JacobDirks/Dirks_EGR314_S26/docs/index.md

---
title: Welcome
tags:
- tag1
- tag2
---
<center>
<font size= "6">Jacob Dirks Datasheet</font><br>
as part of<br>
<font size= "8"> Rugged Surveyor</font><br>
for<br>
<font size= "5"> Team 308 </font><br>

**Submission: May 04, 2026**
</center>

## **Introduction**

* This datasheet is to help define the drive system for the Rugged Surveyor. This system is crucial to the submarine to be able to go underwater and gather data regarding environmental changes specifically through a photo-resistor for light sensing and a temperature sensor. The goal of the drive train is to allow the robot to travel: forward, reverse, and their diagonals as well as turn left or right. This will be accomplished through 3 DC motors and 2 RC servo motors. As for the goal of the overall project, we want to protect human lives and make the process of exploring new environments less dangerous.

### **Project Summary**

* This project is to create full robotic system that can work either as an attachment to a larger robot or as a standalone robot. In this case my team is working to build a submarine that will be able to gather temperature data and light levels in a given area. In order to access the full team's report please access this link: [linked team report.](https://egr314-s-2026-308.github.io/)

### **My Contribution**

* My subsystem is in charge of the drive system for the submarine and using SPI protocol for communication to parts as I use UART for inter controller communication.
* ["Block Diagram"](https://jacobdirks.github.io/Dirks_EGR314_S26/02-Block-Diagram/Block-Diagram/)
* ["Component Selection"](https://jacobdirks.github.io/Dirks_EGR314_S26/03-Component-Selection/Component-Selection/)
* ["Power Budget"](https://jacobdirks.github.io/Dirks_EGR314_S26/10-Power-Budget/Power-Budget/)
* ["Schematic"](https://jacobdirks.github.io/Dirks_EGR314_S26/05-Schematic/schematic/)
* ["PCB"](https://jacobdirks.github.io/Dirks_EGR314_S26/06-PCB/pcb/)
* ["BOM"](https://jacobdirks.github.io/Dirks_EGR314_S26/04-BOM/BOM/)
* ["API"](https://jacobdirks.github.io/Dirks_EGR314_S26/07-API/api/)
* ["Reflection"](https://jacobdirks.github.io/Dirks_EGR314_S26/08-Reflection/Reflection/)
* ["Hardware Version 2"](https://jacobdirks.github.io/Dirks_EGR314_S26/Hardware%20V2.0/HardwareV2/)
* ["Appendix"](https://jacobdirks.github.io/Dirks_EGR314_S26/Appendix/)
  * ["Microcontroller Selection Process"](https://jacobdirks.github.io/Dirks_EGR314_S26/Appendix/02-Microcontroller-Selection/esp-32-table/)
