JacobDirks/Dirks_EGR314_S26/docs/05-Schematic/schematic.md

---
title: Module Schematic
---

## **Overview**

This schematic is design to support the shared power system required by the team and act as the drive system.

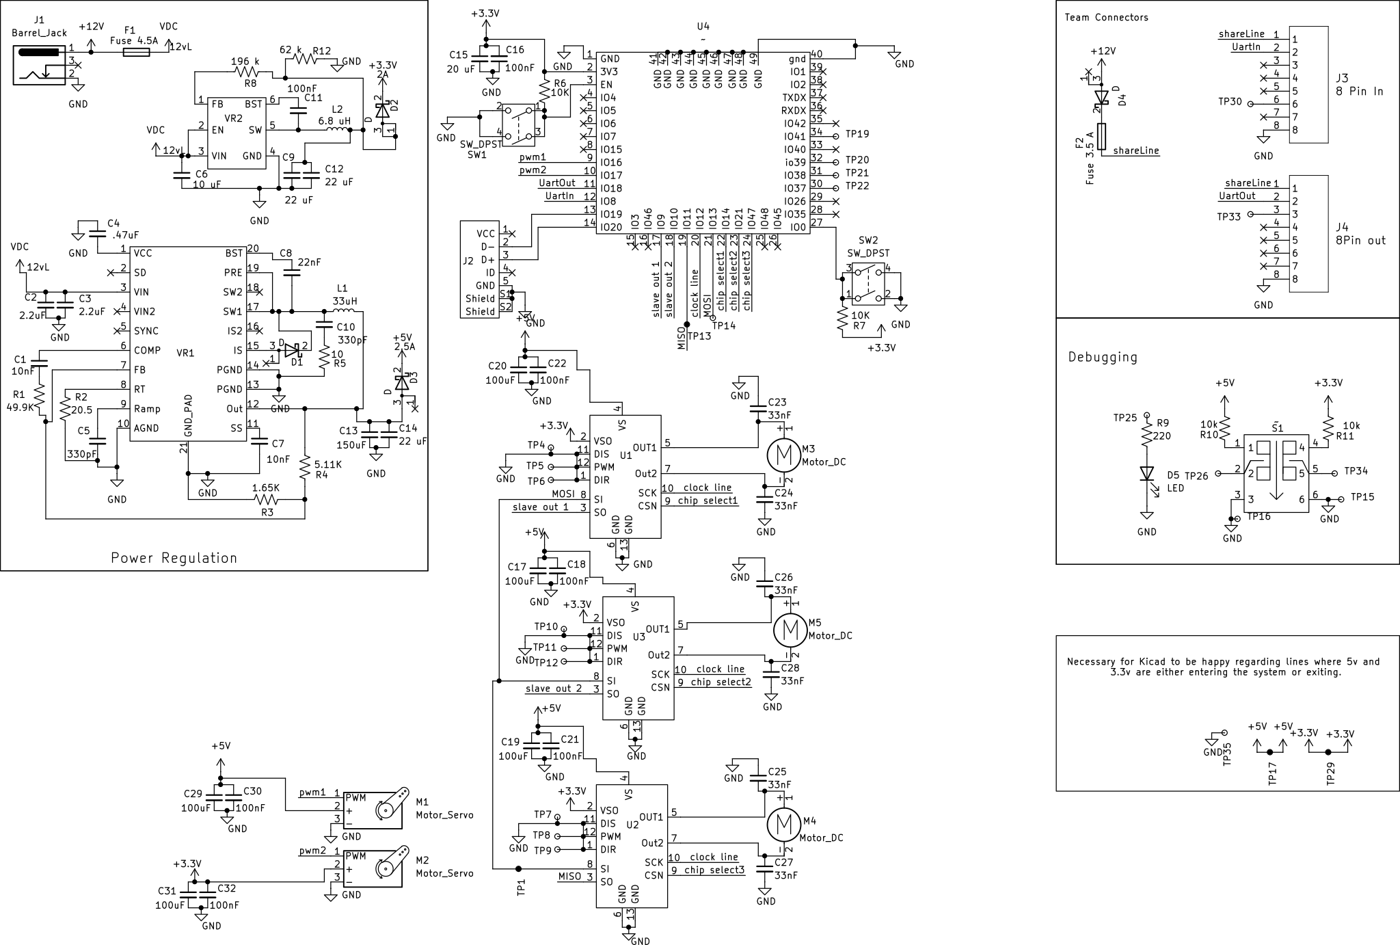
[picture p1: docs/05-Schematic/JdirksSchematic.png]
schematic

**Figure #1:** Showing the schematic.

## **Resources**

The schematic is available [*as a pdf here*](JdirksSchematic.pdf), and the Zip folder of the [*project here*](Projects.zip).
