JacobDirks/Dirks_EGR314_S26/docs/06-PCB/pcb.md

---
title: Module's PCB
---

## **PCB**

This pcb is designed to not only match the schematic but also support the team's movement requirements.

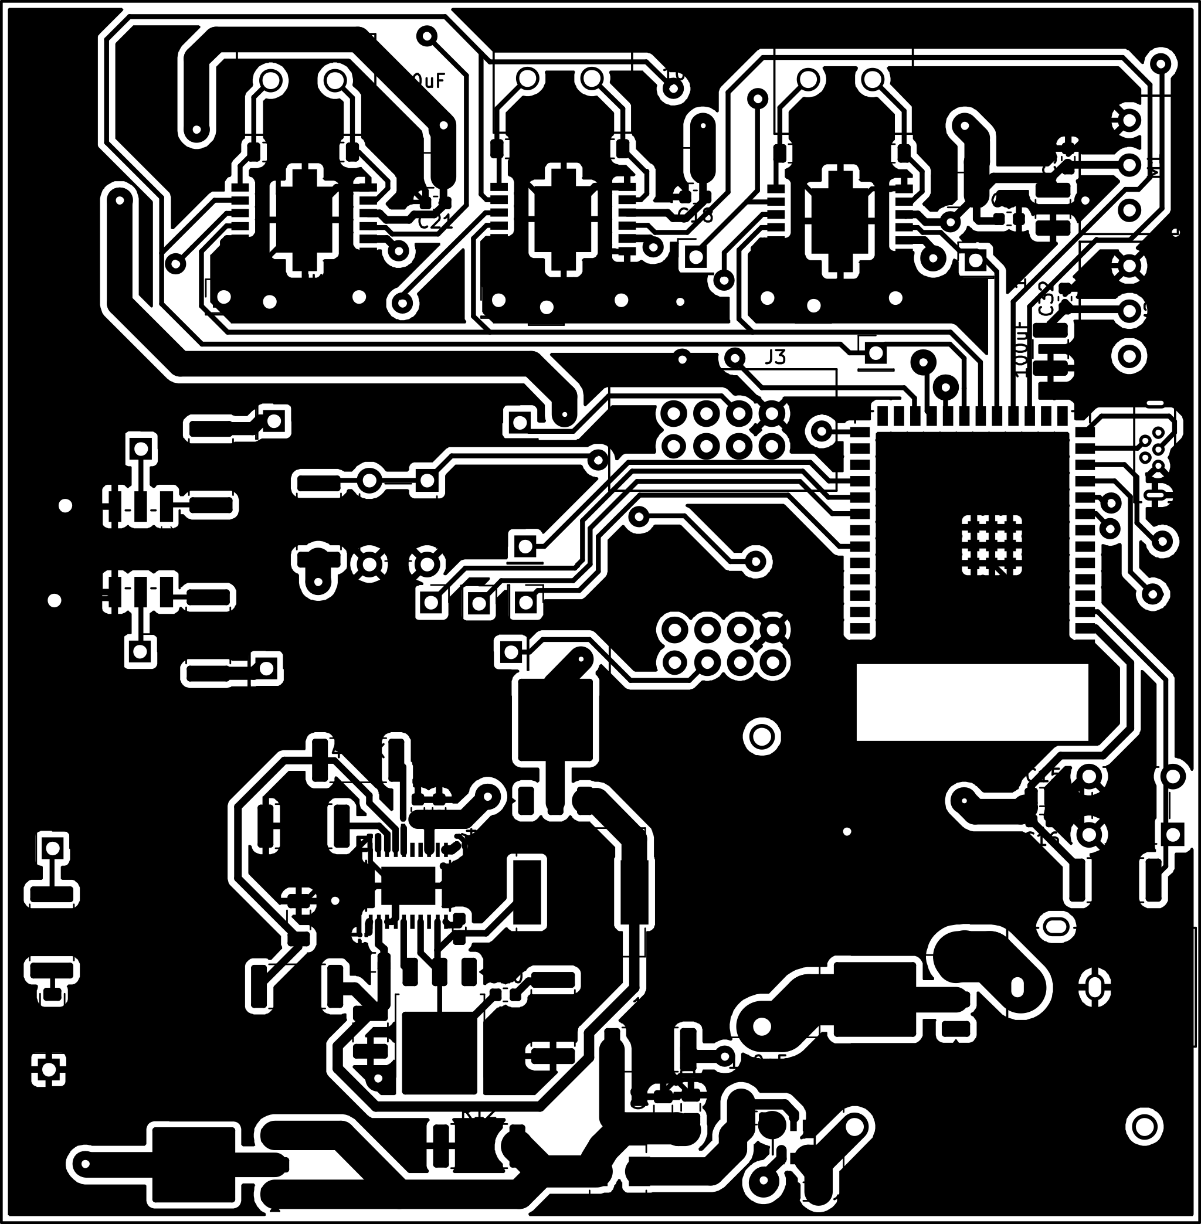
[picture p2: docs/06-PCB/DirksPCB.png]
schematic

**Figure #1:** Showing a screenshot as rendered through KiCad of my pcb.

## **Resources**

The schematic is available [*as a pdf here*](DirksPCB.pdf), and the Zip folder of the [*project here*](Projects.zip) and the [*Gerber files*](Dirks_Gerbers.zip).

## **FinalImages**

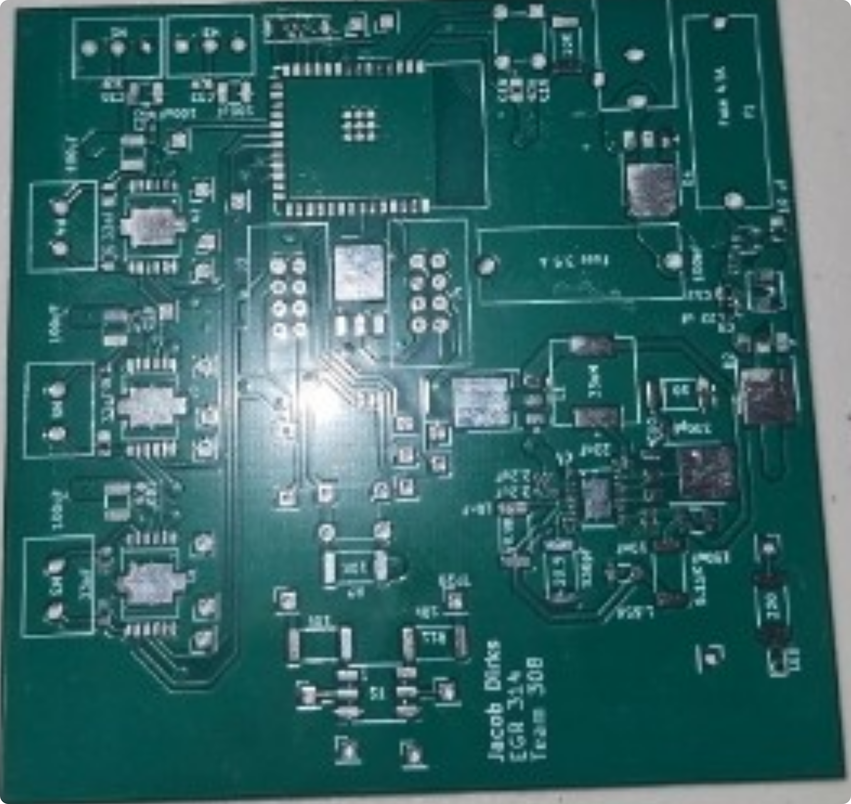
[picture p3: docs/06-PCB/FrontHalf.png]
Empty Front Image

**Figure #2:** Empty top image of the PCB

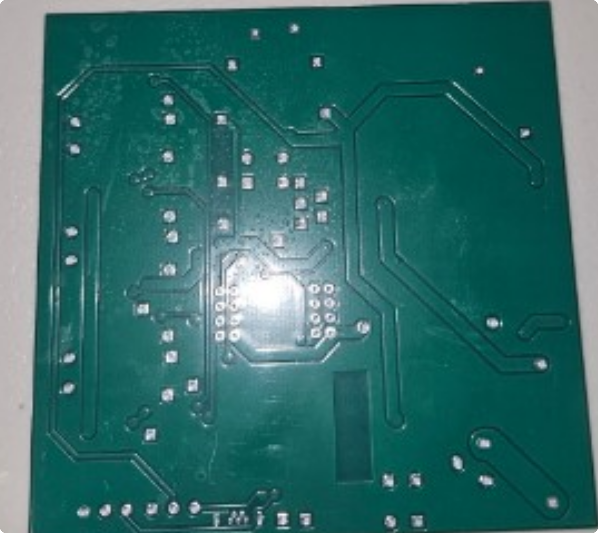
[picture p4: docs/06-PCB/backHalf.png]
Empty Back Image

**Figure #3:** Empty bottom image of the PCB

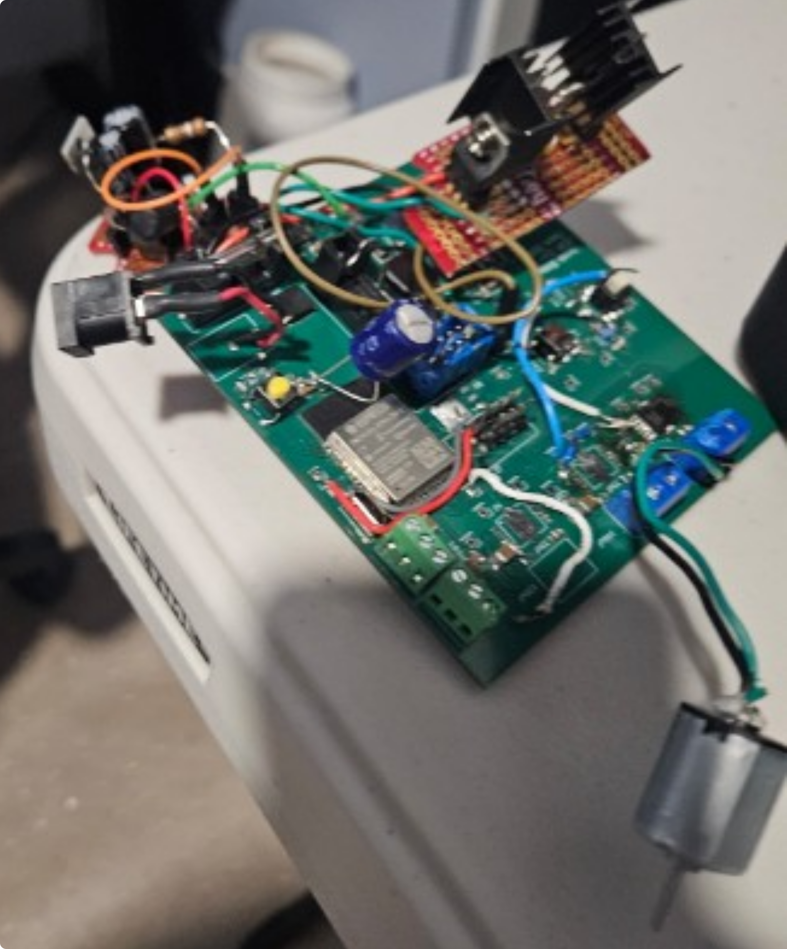
[picture p5: docs/06-PCB/finalTopPCB.png]
Final Front Populated

**Figure #4:** Populated top image of the PCB

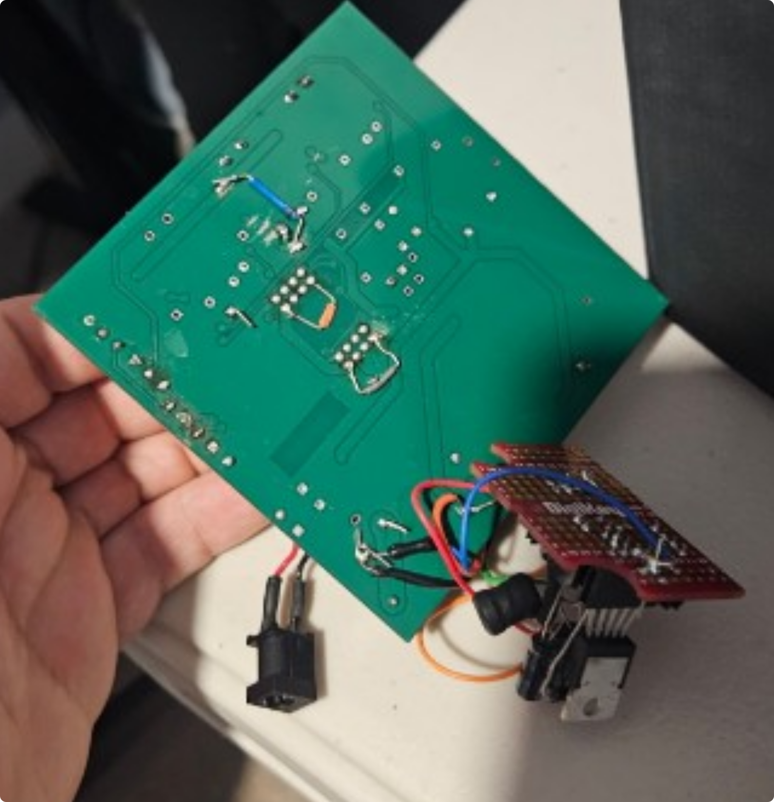
[picture p6: docs/06-PCB/finalBottomPCB.png]
Final Back Populated

**Figure #5:** Populated bottom image of the PCB
