JacobDirks/Dirks_EGR314_S26/docs/Resources/Resources.md

---
title = Resources
---

## **Code Resources**

As provided earlier in the website here is the ["code base."](Dirks_subsystem.zip)

## **3D Print Resources**

This section is new but holds the zip of the ["3D print files"](3dPartsSubmarine.zip) utilized by my subsystem and the team's overall model.
