JacobDirks/Dirks_EGR314_S26/docs/04-BOM/DirksBOM.pdf

Part Name/Description

Unit
Quantity

Unit
Prototype
Cost

Total
Prototype
Cost

Unit
Production
Cost

Total
Production
Cost | Manufacturer | Manufacturer Part # | Vendor Link
ESP 32 - Wroom N8 | 1 | $5.49 | $5.49 | $5.49 | $5.49 | Espressif | ESP32-S3-WROOM-1-N8https://www.digikey.com/en/products/detail/espressif-systems/ESP32-S3-WROOM-1-N8/15200089
CAP CER 330PF 16V X7R 0201 | 2 | $0.10 | $0.20 | $0.10 | $0.20 | Murata | GRM033R71C331KA01Dhttps://www.digikey.com/en/products/detail/murata-electronics/GRM033R71C331KA01D/2543513
CAP CER 10000PF 10V X7S 010052 | $0.08 | $0.16 | $0.08 | $0.16 | Murata | GRM022C71A103KE01Lhttps://www.digikey.com/en/products/detail/murata-electronics/GRM022C71A103KE01L/16820994
CAP CER 0.022UF 6.3V X5R 0201 1 | $0.10 | $0.10 | $0.10 | $0.10 | Murata | GRM033R60J223KE01Dhttps://www.digikey.com/en/products/detail/murata-electronics/GRM033R60J223KE01D/702435
CAP 0805 250V 33 NF X7R | 6 | $0.18 | $1.08 | $0.18 | $1.08 | Yageo | CC0805KKX7RYBB333 | https://www.digikey.com/en/products/detail/yageo/CC0805KKX7RYBB333/20376243
CAP CER 0.1UF 10V X5R 0201 | 7 | $0.08 | $0.56 | $0.08 | $0.56 | Murata | GRM033R61A104KE15Dhttps://www.digikey.com/en/products/detail/murata-electronics/GRM033R61A104KE15D/2269163
CAP CER 0.47UF 6.3V X5R 0201 1 | $0.08 | $0.08 | $0.08 | $0.08 | Murata | GRM033R60J474KE90Dhttps://www.digikey.com/en/products/detail/murata-electronics/GRM033R60J474KE90D/5027494
CAP CER 2.2UF 16V X5R 0603 | 2 | $0.10 | $0.20 | $0.10 | $0.20 | Samsung Electro-Mechanics CL10A225KO8NNNC | https://www.digikey.com/en/products/detail/samsung-electro-mechanics/CL10A225KO8NNNC/3886698
CAP CER 10UF 16V X5R 0805 | 1 | $0.08 | $0.08 | $0.08 | $0.08 | Taiyo Yuden | EMK212BJ106KG-T | https://www.digikey.com/en/products/detail/taiyo-yuden/EMK212BJ106KG-T/930647
CAP CER 22UF 6.3V 20% X5R 04024 | $0.28 | $1.12 | $0.28 | $1.12 | Murata | GRM155R60J226ME11Dhttps://www.digikey.com/en/products/detail/murata-electronics/GRM155R60J226ME11D/5253988
CAP CER 100UF 16V X5R 1210 | 5 | $1.74 | $8.70 | $1.74 | $8.70 | Taiyo Yuden | EMK325ABJ107MM-T | https://www.digikey.com/en/products/detail/taiyo-yuden/EMK325ABJ107MM-T/2774763
CAP CER 150UF 6.3V X5R 1210 1 | $1.31 | $1.31 | $1.31 | $1.31 | Samsung Electro-Mechanics CL32A157MQVNNNE | https://www.digikey.com/en/products/detail/samsung-electro-mechanics/CL32A157MQVNNNE/3889025
RES 10 OHM 5% 2W 2512 | 1 | $0.44 | $0.44 | $0.44 | $0.44 | Bourns | CRM2512-JW-100ELF | https://www.digikey.com/en/products/detail/bourns-inc/CRM2512-JW-100ELF/2563944
RES 20 OHM 5% 2W 2512 | 1 | $0.24 | $0.24 | $0.24 | $0.24 | Yageo | AC2512JK-7W20RL | https://www.digikey.com/en/products/detail/yageo/AC2512JK-7W20RL/17011699
RES 220 OHM 5% 2W 2512 | 1 | $0.53 | $0.53 | $0.53 | $0.53 | TE Connectivity Passive CRGH2512J220R | https://www.digikey.com/en/products/detail/te-connectivity-passive-product/CRGH2512J220R/2386098
RES 1.65K OHM 1% 2W 1206 | 1 | $1.39 | $1.39 | $1.39 | $1.39 | TE Connectivity Passive 3503G2B1K65FTD | https://www.digikey.com/en/products/detail/te-connectivity-passive-product/3503G2B1K65FTD/16808524
RES 5.11K OHM 1% 2W 2512 | 1 | $0.52 | $0.52 | $0.52 | $0.52 | Bourns | CRM2512-FX-5111ELF | https://www.digikey.com/en/products/detail/bourns-inc/CRM2512-FX-5111ELF/7314836
RES 10K OHM 1% 2W 2512 | 1 | $0.51 | $0.51 | $0.51 | $0.51 | TE Connectivity Passive CRGP2512F10K | https://www.digikey.com/en/products/detail/te-connectivity-passive-product/CRGP2512F10K/8577335
RES 49.9K OHM 1% 2W 2512 | 1 | $0.52 | $0.52 | $0.52 | $0.52 | Bourns | CRM2512-FX-4992ELF | https://www.digikey.com/en/products/detail/bourns-inc/CRM2512-FX-4992ELF/4698402
RES 62K OHM 5% 1/8W 0805 | 1 | $10.00 | $10.00 | $10.00 | $10.00 | Yageo | RC0805JR-0762KL | https://www.digikey.com/en/products/detail/yageo/RC0805JR-0762KL/728360
RES SMD 196K OHM 1% 1/4W 08051 | $0.10 | $0.10 | $0.10 | $0.10 | Vishay Dale | RES SMD 196K OHM 1% 1/4W 0805 https://www.digikey.com/en/products/detail/vishay-dale/CRCW0805196KFKEA/1175896
DIODE SCHOTTKY 100V 3.5A TO252AA 3 | $0.40 | $1.20 | $0.40 | $1.20 | Vishay | VS-30WQ10FNTR-M3 | https://www.digikey.com/en/products/detail/vishay-general-semiconductor-diodes-division/VS-30WQ10FNTR-M3/4933700
LED GREEN CLEAR SMD | 1 | $0.10 | $0.10 | $0.10 | $0.10 | Lite-On | LTST-C170GKT | https://www.digikey.com/en/products/detail/liteon/LTST-C170GKT/269226
FUSE GLASS 5A 250VAC 5X20MM1 | $0.63 | $0.63 | $0.63 | $0.63 | Schurter | 34.3124 | https://www.digikey.com/en/products/detail/schurter-inc/0034-3124/639681
FUSE GLASS 4A 250VAC 5X20MM1 | $0.63 | $0.63 | $0.63 | $0.63 | Schurter | 34.3123 | https://www.digikey.com/en/products/detail/schurter-inc/0034-3123/639683
FIXED IND 4.7UH 2.5A 147.2 MOHM1 | $0.19 | $0.19 | $0.19 | $0.19 | Taiyo Yuden | NRS4018T6R8MDGJ | https://www.digikey.com/en/products/detail/taiyo-yuden/NRS4018T6R8MDGJ/2648972
FIXED IND 33UH 2.5A 93.6 MOHM1 | $1.06 | $1.06 | $1.06 | $1.06 | Murata | 1274AS-H-330M=P3 | https://www.digikey.com/en/products/detail/murata-electronics/1274AS-H-330M-P3/5271492
Positional Rotation DC Motor Servomotor, RC (Hobby) 3 ~ 6VDC 2 | $5.95 | $11.90 | $5.95 | $11.90 | Adafruit | 4326 | https://www.digikey.com/en/products/detail/adafruit-industries-llc/4326/10419470
STANDARD MOTOR 11605 RPM 5V3 | $3.71 | $11.13 | $3.71 | $11.13 | NMB | PPN7PA12C1 | https://www.digikey.com/en/products/detail/nmb-technologies-corporation/PPN7PA12C1/2417079
8 Pin Connector | 2 | $1.48 | $2.96 | $1.48 | $2.96 | Molex | 702460801 | https://www.digikey.com/en/products/detail/molex/0702460801/760165
8 Pin Ribbon Cable | 2 | $5.00 | $10.00 | $5.00 | $10.00 | Amphenol | 10124667-Z0025YYLF | https://www.digikey.com/en/products/detail/amphenol-cs-fci/10124667-Z0025YYLF/7590774
Power Barrel Connector Jack 2.00mm ID (0.079"), 5.50mm OD (0.217") Through Hole, Right Angle 1 | $0.71 | $0.71 | $0.71 | $0.71 | Same Sky | PJ-102AH | https://www.digikey.com/en/products/detail/same-sky-formerly-cui-devices/PJ-102AH/408448
USB - micro B USB 2.0 | 1 | $0.77 | $0.77 | $0.77 | $0.77 | GCT | USB3131-30-0230-A | https://www.digikey.com/en/products/detail/gct/USB3131-30-0230-A/9859642
Switch button | 2 | $0.10 | $0.20 | $0.10 | $0.20 | Same Sky | TS02-66-55-BK-100-LCR-Dhttps://www.digikey.com/en/products/detail/same-sky-formerly-cui-devices-/TS02-66-55-BK-100-LCR-D/15634297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
SWITCH PB DPDT 0.1A 30V | 1 | $0.46 | $0.46 | $0.46 | $0.46 | E-Switch | TL2233OA | https://www.digikey.com/en/products/detail/e-switch/TL2233OA/15220943
IC HALF BRIDGE DRIVER 6A 12DSO3 | $3.55 | $10.65 | $3.55 | $10.65 | Infineon | IFX9201SGAUMA1 | https://www.digikey.com/en/products/detail/infineon-technologies/IFX9201SGAUMA1/5415542

# Bill of Materials Motor Subsystem

Buck Switching Regulator IC Positive Adjustable 1.225V 1 Output 2.5A 20-PowerTSSOP (0.173", 4.40mm Width) 1 | $3.77 | $3.77 | $3.77 | $3.77 | Texas InstrumentsLM5005MHX/NOPB | https://www.digikey.com/en/products/detail/texas-instruments/LM5005MHX-NOPB/1871800
Buck Switching Regulator IC Positive Fixed 3.3V 1 Output 2A SOT-23-6 Thin, TSOT-23-6 1 | $0.71 | $0.71 | $0.71 | $0.71 | Diode IncorporatedAP63203WU-7 | https://www.digikey.com/en/products/detail/diodes-incorporated/AP63203WU-7/9858426
3 Pin Screw Terminal | 2 | $0.71 | $1.42 | $0.71 | $1.42 | Adam Tech | EBWA-03-A | https://www.digikey.com/en/products/detail/adam-tech/EBWA-03-A/9830974
2 Pin Screw Terminal | 3 | $0.32 | $0.96 | $0.32 | $0.96 | Same Sky | TB002-500-02BE | https://www.digikey.com/en/products/detail/same-sky-formerly-cui-devices/TB002-500-02BE/10064069
Total Prototype cost $87.09 | Total Production cost$87.09

Datasheet Link | Supplier | Supplier Part # | # Ordered | Date Ordered | # Received | Surplu s | Schematic Reference Designators
https://documentation.espressif.com/esp32-s3-wroom-1_wroom-1u_datasheet_en.pdf Digikey | | 5407-ESP32-S3-WROOM-1-N8CT-ND 3 | | 3/12/2026 | 3 | 2 | U4
https://search.murata.co.jp/Ceramy/image/img/A01X/G101/ENG/GRM033R71C331KA01-01A.pdf Digikey | | 490-11359-1-ND | 2 | 3/12/2026 | 2 | 0 | C5,C10
https://search.murata.co.jp/Ceramy/image/img/A01X/G101/ENG/GRM022C71A103KE01-01A.pdf Digikey | | 490-GRM022C71A103KE01LCT-ND 1 | | 3/12/2026 | 2 | 0 | C1,C7
https://search.murata.co.jp/Ceramy/image/img/A01X/G101/ENG/GRM033R60J223KE01-01.pdf Digikey | | 490-3169-1-ND | 1 | 3/12/2026 | 1 | 0 | C8
https://www.yageo.com/en/Chart/Download/pdf/CC0805KKX7RYBB333 Digikey | | 13-CC0805KKX7RYBB333CT-ND 1 | | 3/12/2026 | 6 | 0 | C23,C24,C25,C26,C27,C28
https://search.murata.co.jp/Ceramy/image/img/A01X/G101/ENG/GRM033R61A104KE15-01A.pdf Digikey | | 490-5881-1-ND | 10 | 3/12/2026 | 10 | 3 | C11,C16,C18,C21,C22,C30,C32
https://search.murata.co.jp/Ceramy/image/img/A01X/G101/ENG/GRM033R60J474KE90-01.pdf Digikey | | 490-10409-1-ND | 1 | 3/12/2026 | 1 | 0 | C4
https://mm.digikey.com/Volume0/opasdata/d220001/medias/docus/421/CL10A225KO8NNNC_Spec.pdf Digikey | | 1276-1040-1-ND | 3 | 3/12/2026 | 3 | 1 | C2,C3
https://mm.digikey.com/Volume0/opasdata/d220001/medias/docus/8412/587_mlcc01hqAUTOe.pdf Digikey | | 587-1295-1-ND | 1 | 3/12/2026 | 1 | 0 | C6
https://search.murata.co.jp/Ceramy/image/img/A01X/G101/ENG/GRM155R60J226ME11-01A.pdf Digikey | | 490-GRM155R60J226ME11DCT-ND 6 | | 3/12/2026 | 6 | 2 | C9,C12,C14,C15
https://mm.digikey.com/Volume0/opasdata/d220001/medias/docus/8412/587_mlcc01hqAUTOe.pdf Digikey | | 587-3152-1-ND | 7 | 3/12/2026 | 7 | 2 | C17,C19,C20,C29,C31
https://weblib.samsungsem.com/mlcc/mlcc-ec-data-sheet.do?partNumber=CL32A157MQVNNN Digikey | | 1276-3367-1-ND | 1 | 3/12/2026 | 1 | 0 | C13
https://www.bourns.com/docs/product-datasheets/crm.pdf Digikey | | CRM2512-JW-100ELFCT-ND 1 | | 3/12/2026 | 1 | 0 | R5
https://yageogroup.com/content/datasheet/asset/file/PYU-AC_51_ROHS_L Digikey | | 13-AC2512JK-7W20RLCT-ND 1 | | 3/12/2026 | 1 | 0 | R2
https://www.te.com/commerce/DocumentDelivery/DDEController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 Digikey | | A126460CT-ND | 1 | 3/12/2026 | 1 | 0 | R9
https://www.te.com/commerce/DocumentDelivery/DDEController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 Digikey | | 1712-3503G2B1K65FTDCT-ND 1 | | 3/12/2026 | 1 | 0 | R3
https://www.bourns.com/docs/product-datasheets/crm.pdf Digikey | | 118-CRM2512-FX-5111ELFCT-ND 1 | | 3/12/2026 | 1 | 0 | R4
https://www.te.com/commerce/DocumentDelivery/DDEController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 Digikey | | A130733CT-ND | 1 | 3/12/2026 | 1 | 0 | R6,R7,R10,R11
https://www.bourns.com/docs/product-datasheets/crm.pdf Digikey | | 118-CRM2512-FX-4992ELFCT-ND 1 | | 3/12/2026 | 1 | 0 | R1
https://yageogroup.com/content/datasheet/asset/file/PYU-RC_GROUP_51_ROHS_L Digikey | | 311-62KARDKR-ND | 0 | 3/12/2026 | 1 | 0 | R8
https://www.vishay.com/docs/20035/dcrcwe3.pdf Digikey | | 541-196KCCT-ND | 0 | 3/12/2026 | 1 | 0 | R12
https://www.vishay.com/docs/93299/vs-30wq10fn.pdf Digikey | | 112-VS-30WQ10FNTR-M3CT-ND 7 | | 3/12/2026 | 7 | 4 | D1,D2,D3,D4,D6
https://mm.digikey.com/Volume0/opasdata/d220001/medias/docus/895/LTST-C170GKT.pdf Digikey | | 160-1179-1-ND | 1 | 3/12/2026 | 1 | 0 | D5
https://www.digikey.com/en/models/639681 Digikey | | 486-1223-ND | 0 | 3/12/2026 | 1 | 0 | F1
https://www.schurter.com/en/datasheet/typ_FST_5x20.pdf Digikey | | 486-1222-ND | 5 | 3/12/2026 | 5 | 4 | F2
https://mm.digikey.com/Volume0/opasdata/d220001/medias/docus/7087/NR-H-S-V%20Datasheet.pdf Digikey | | 587-2894-6-ND | 0 | 3/12/2026 | 1 | 0 | L2
https://search.murata.co.jp/Ceramy/image/img/P02/J(E)TE243B-0058_DEM10050C_reference.pdf Digikey | | 490-10851-1-ND | 1 | 3/12/2026 | 1 | 0 | L1
https://mm.digikey.com/Volume0/opasdata/d220001/medias/docus/694/4326_Web.pdf Digikey | | 1528-4326-ND | 3 | 3/12/2026 | 3 | 1 | M1,M2
https://mm.digikey.com/Volume0/opasdata/d220001/medias/docus/6448/ppn7%20Datasheet.pdf Digikey | | 942-PPN7PA12C1-ND 3 | | 3/12/2026 | 3 | 0 | M3, M4, M5
https://www.molex.com/en-us/products/part-detail/702460801?display=pdf Digikey | | 900-0702460801-ND | 0 | 3/12/2026 | 2 | 0 | J3, J4
https://cdn.amphenol-cs.com/media/wysiwyg/files/drawing/10124667.pdf Digikey | | 10124667-Z0025YYLF-ND0 | | 3/12/2026 | 2 | 0 | J3, J4
https://www.cuidevices.com/product/resource/pj-102ah.pdf Digikey | | CP-102AH-ND | 1 | 3/12/2026 | 1 | 0 | J1
https://gct.co/files/specs/usb3131-spec.pdf Digikey | | 2073-USB3131-30-0230-ACT-ND 0 | | 3/12/2026 | 1 | 0 | J2
https://www.sameskydevices.com/product/resource/ts02.pdf Digikey | | 2223-TS02-66-55-BK-100-LCR-D-ND 0 | | 3/12/2026 | 2 | 0 | SW1,SW2
https://configured-product-images.s3.amazonaws.com/Datasheets/TL2233.pdf Digikey | | 141-TL2233OACT-ND 1 | | 3/12/2026 | 1 | 0 | S1
https://www.infineon.com/dgdl/Infineon-IFX9201SG-DS-v01_01-EN.pdf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 Digikey | | IFX9201SGAUMA1CT-ND | | 3/12/2026 | 3 | 0 | U1,U2,U3

# Bill of Materials Motor Subsystem

https://www.ti.com/general/docs/suppproductinfo.tsp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 Digikey | LM5005MHX/NOPBCT-ND2 | | 3/12/2026 | 2 | 1 | VR1
https://www.diodes.com/assets/Datasheets/AP63200-AP63201-AP63203-AP63205.pdf Digikey | AP63203WU-7DICT-ND2 | | 3/12/2026 | 2 | 1 | VR2
https://app.adam-tech.com/products/download/data_sheet/204239/ebwa-xx-a-data-sheet.pdf Digikey | 2057-EBWA-03-A-ND 2 | | 3/12/2026 | 2 | 0 | M1,M2
https://www.cuidevices.com/product/resource/tb002-500.pdf Digikey | 102-6145-ND | 0 | 3/12/2026 | 3 | 0 | M3, M4, M5
