JacobDirks/Dirks_EGR314_S26/docs/10-Power-Budget/DirksPowerBudget.xlsx

Power Budget Dirks EGR 314
Team Number: | 308
Project Name:
Team Member Names: | Jacob D, Sam B, Sam M, Adrian P, Andrew, Mo
Version: | 1.1
A. List ALL major components (active devices, integrated circuits, etc.) except for power sources, voltage regulators, resistors, capacitors, or passive elements
All Major Components | Component Name | Part Number | Supply Voltage Range | # | Absolute Maximum Current (mA) | Total Current (mA) | Unit
 | ESP-32 | ESP32-S3-WROOM-1 | "+3 to -3 V" | 1 | 1000 | 1000 | mA
 | DC Motor | PPN7PA12C1 | +5V | 3 | 567 | 1701 | mA
 |  |  |  |  | 1567 | 2701 | mA
B. Assign each major component above to ONE power rail below. Try to minimize the number of different power rails in the design. Add additional power rails or change the power rail voltages if needed.
+12V Power Rail | Component Name | Part Number | Supply Voltage Range | # | Absolute Maximum Current (mA) | Total Current (mA) | Unit
 | 3.3V Regulator | A4402KLPTR-T | 1.8V -3.3V | 1 | 250 | 250 | mA
 | 5V regulator | A4402KLPTR-T | 3.3V - 5V | 1 | 1000 | 1000 | mA
 |  |  |  |  |  | 0 | mA
 |  |  |  |  |  | 0 | mA
 |  |  |  |  |  | 0 | mA
 | Subtotal |  |  |  |  | 1250 | mA
 | Safety Margin |  |  |  |  | 25%
 | Total Current Required on +12V Rail |  |  |  |  | 1562.5 | mA
c1. Regulator or Source Choice | +12V regulator | LM7812 | +12V - 35V | 1 | 6000 | 6000 | mA
 | Total Remaining Current Available on +12V Rail |  |  |  |  | 4437.5 | mA
+5V Power Rail | Component Name | Part Number | Supply Voltage Range | # | Absolute Maximum Current (mA) | Total Current (mA) | Unit
 | DC Motor | PPN7PA12C1 | +5V | 3 | 560 | 1680 | mA
 | RC Servo | 4326 | 3-9V | 1 | 300 | 300 | mA
 |  |  |  |  |  | 0 | mA
 |  |  |  |  |  | 0 | mA
 | Subtotal |  |  |  |  | 1980 | mA
 | Safety Margin |  |  |  |  | 25%
 | Total Current Required on +5V Rail |  |  |  |  | 2475 | mA
c2. Regulator or Source Choice | 5V regulator | A4402KLPTR-T | 3.3V - 5V | 1 | 2500 | 2500 | mA
 | Total Remaining Current Available on +5V Rail |  |  |  |  | 25 | mA
+3.3V Power Rail | Component Name | Part Number | Supply Voltage Range | # | Absolute Maximum Current (mA) | Total Current (mA) | Unit
 | ESP-32 | ESP32-S3-WROOM-1 | "+3 to -3 V" | 1 | 1000 | 1000 | mA
 | RC Servo | 4326 | 3-9V | 1 | 300 | 300 | mA
 |  |  |  |  |  | 0 | mA
 |  |  |  |  |  | 0 | mA
 | Subtotal |  |  |  |  | 1300 | mA
 | Safety Margin |  |  |  |  | 25%
 | Total Current Required on +3.3V Rail |  |  |  |  | 1625 | mA
c4. Regulator or Source Choice | 3.3V Regulator | A4402KLPTR-T | 1.8V -3.3V | 1 | 2000 | 2000 | mA
 | Total Remaining Current Available on 3.3V Rail |  |  |  |  | 375 | mA
C. For each power rail above, select a specific voltage regulator using the same process as for major component selection. Confirm that the Total Remaining Current Available on each rail above is not negative.
D. Select a specific external power source (wall supply or battery) for your system, and confirm that it can supply all of the regulators for all of the power rails simultaneously. If you need multiple power sources, list each separately below and indicate which regulators will be connected to each supply. Confirm that the Total Remaining Current Available on each power source below is not negative.
External Power Source 1 | Component Name | Part Number | Supply Voltage Range | Output Voltage | Absolute Maximum Current (mA) | Total Current (mA) | Unit
Power Source 1 Selection | Plug-in Wall Supply | (full part number) | 110VAC | +24V | 5000 | 5000 | mA
Power Rails Connected to External Power Source 1 | +12V regulator | LM7812 | +12V - 35V | 1 | 1000 | 1000 | mA
 | 5V regulator | A4402KLPTR-T | 3.3V - 5V | 1 | 1000 | 1000 | mA
 | 3.3V Regulator | A4402KLPTR-T | 1.8V -3.3V | 1 | 250 | 250 | mA
 | Total Remaining Current Available on External Power Source 1 |  |  |  |  | 2750 | mA
