JacobDirks/Dirks_EGR314_S26/docs/02-Block-Diagram/resources/Dirks_EGR314_BlockDiagram.pdf

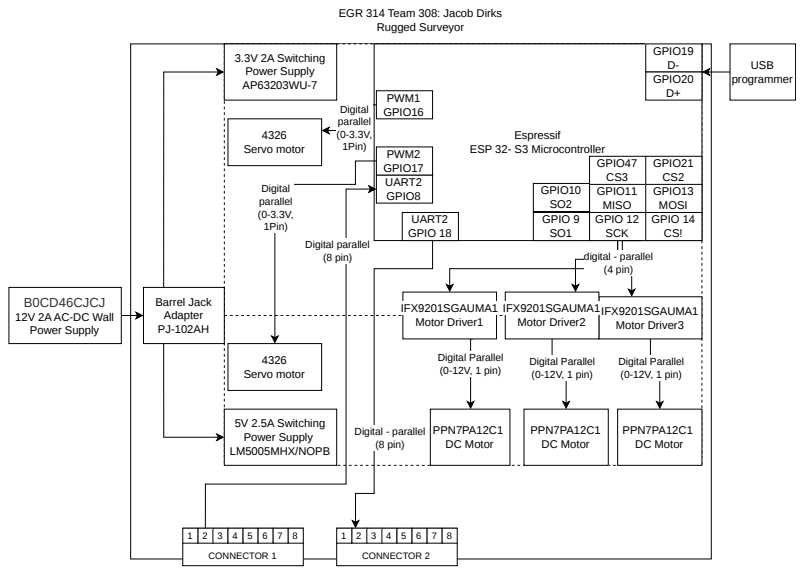
[picture p14: page 1]
Rugged Surveyor; PPN7PA12C1 DC Motor; Digital Parallel (0-12V, 1 pin); IFX9201SGAUMA1; 3.3V 2A Switching Power Supply AP63203WU-7; Espressif ESP 32- S3 Microcontroller; GPIO11 MISO GPIO 12 SCK; digital - parallel (4 pin); GPIO 14 CS!; Digital parallel (8 pin); UART2 GPIO8; Digital - parallel (8 pin); UART2 GPIO 18; USB programmer; 5V 2.5A Switching Power Supply LM5005MHX/NOPB; GPIO13 MOSI; GPIO19 D- GPIO20 D+; 4326 Servo motor; Digital parallel (0-3.3V, 1Pin); PWM1 GPIO16; PWM2; GPIO17; GPIO47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

EGR 314 Team 308: Jacob Dirks

B0CD46CJCJ
12V 2A AC-DC Wall
Power Supply

Barrel Jack Adapter PJ-102AH

IFX9201SGAUMA1 | IFX9201SGAUMA1
Motor Driver1 | Motor Driver2 | Motor Driver3

CONNECTOR 1 | | | | | | | | CONNECTOR 2
