JacobDirks/Dirks_EGR314_S26/docs/05-Schematic/JdirksSchematic.pdf

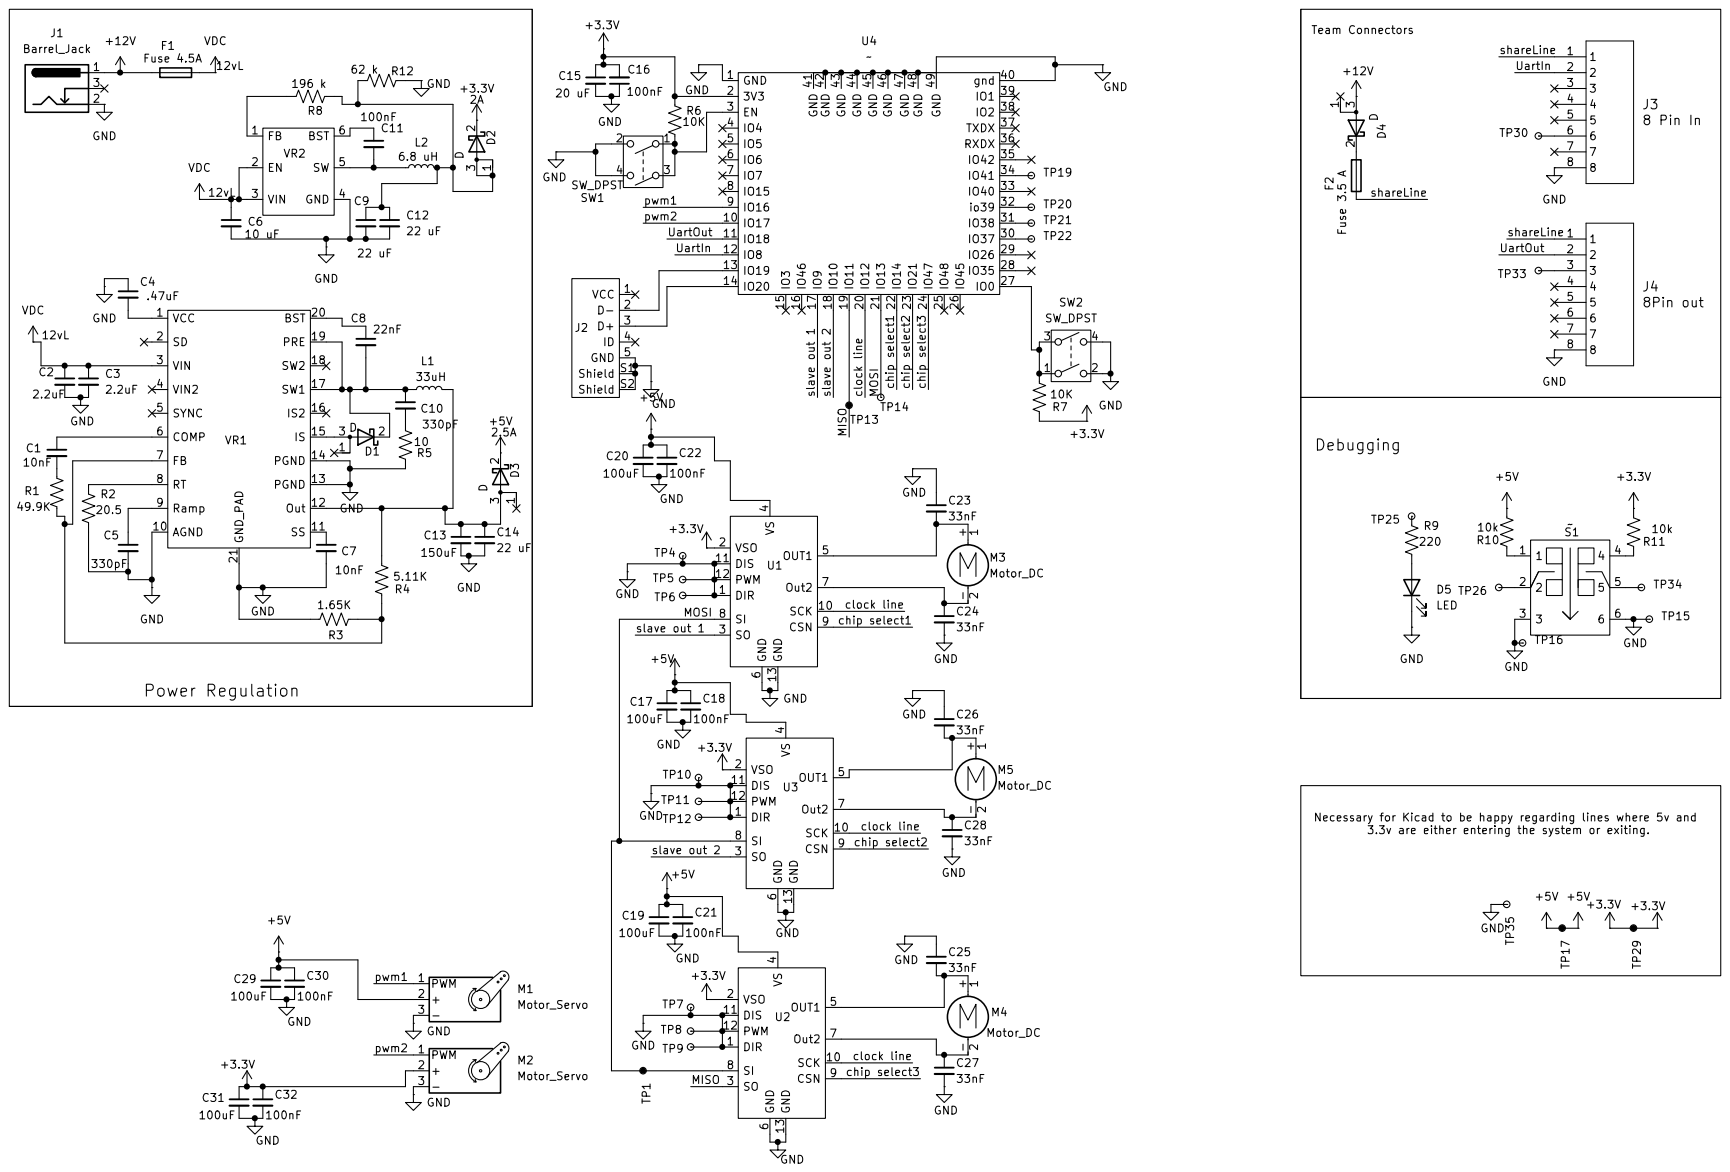
[picture p15: page 1]
