JacobDirks/Dirks_EGR314_S26/docs/06-PCB/DirksPCB.pdf

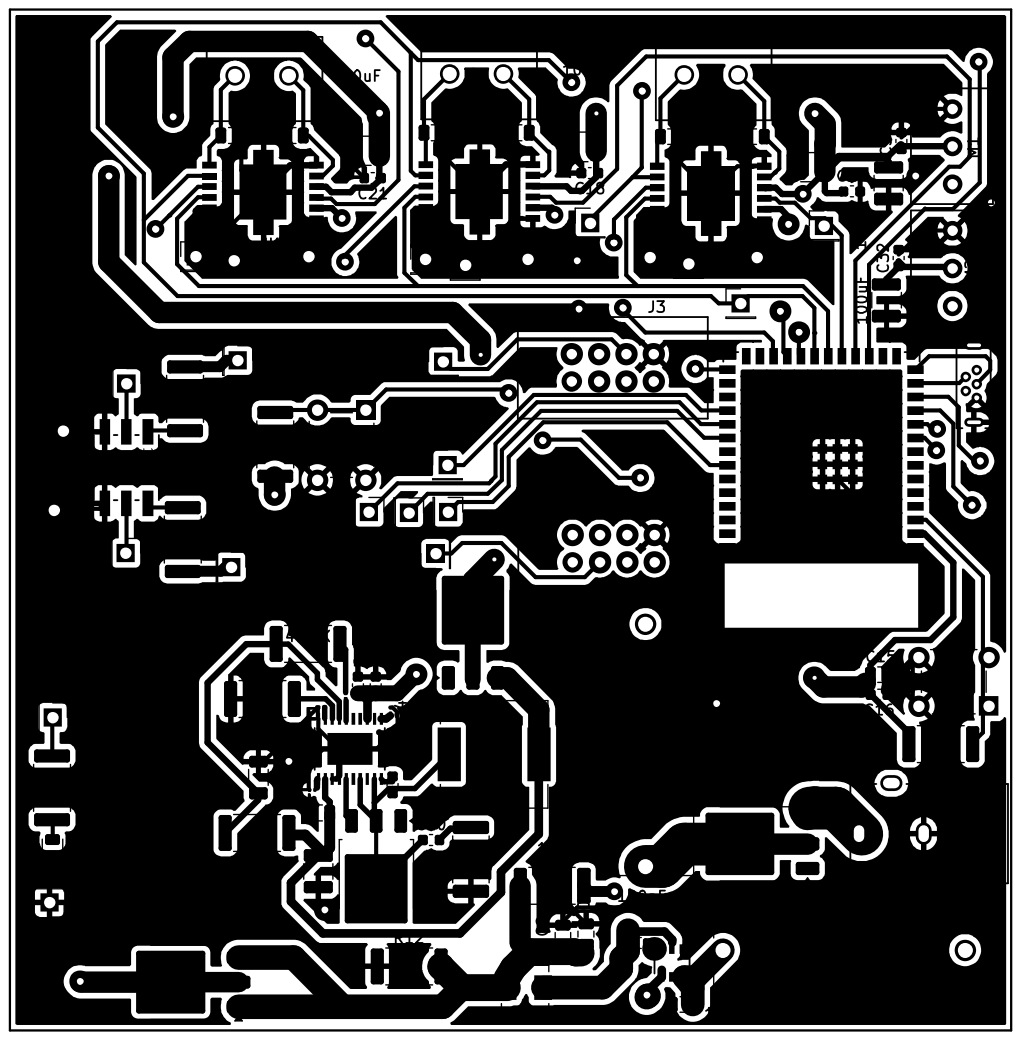
[picture p16: page 1]
