JacobDirks/Dirks_EGR314_S26/docs/05-Schematic/Dirks_IndividualSubsystem.kicad_sch

## KiCad design docs/05-Schematic/Dirks_IndividualSubsystem.kicad_sch (2026-03-06)

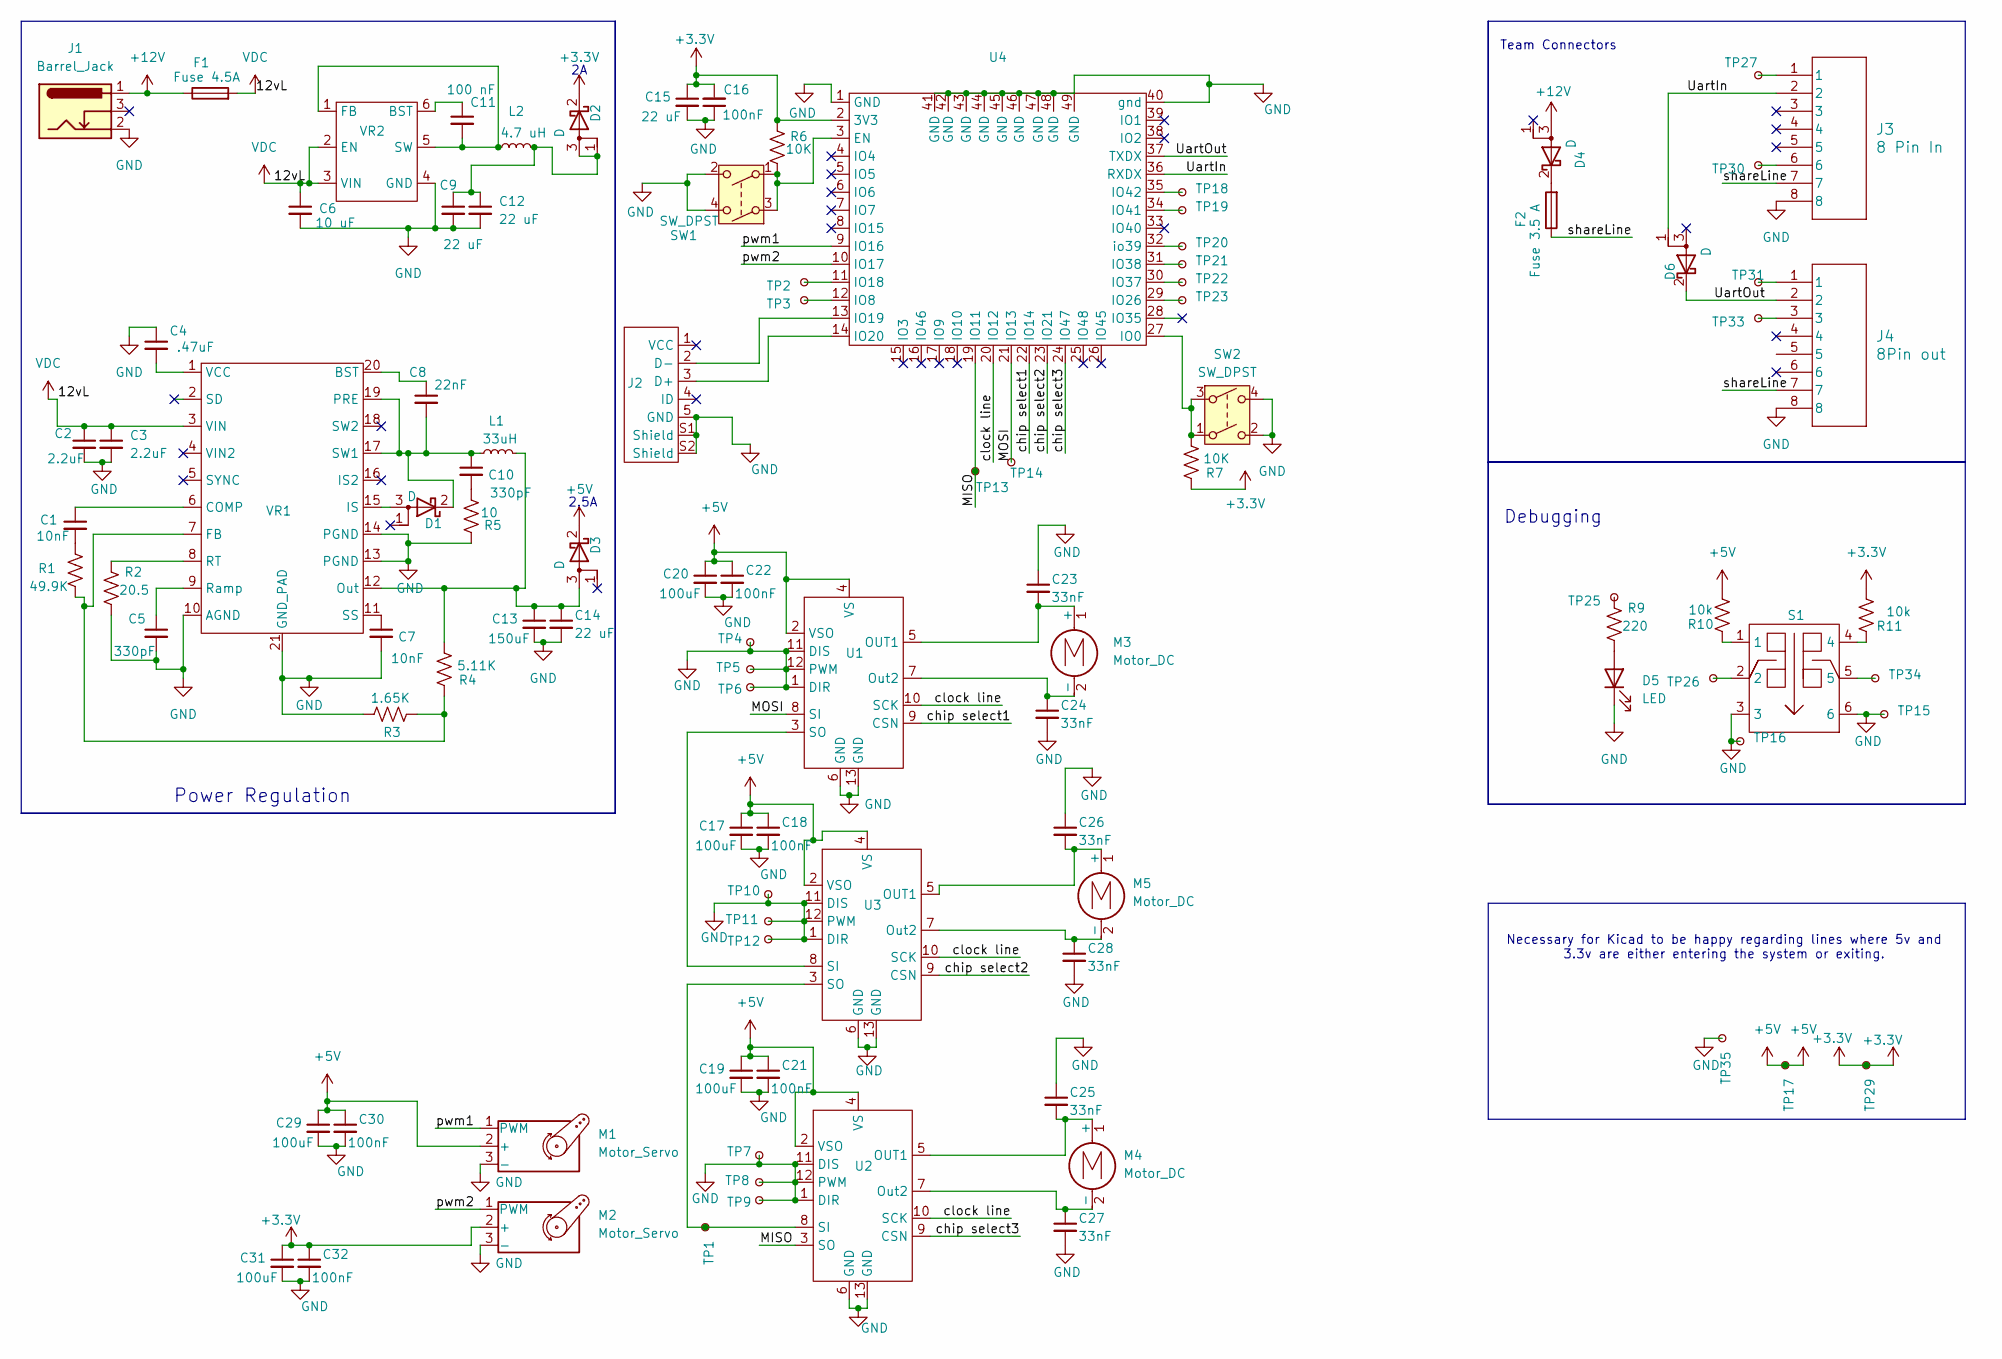
[picture p17: schematic Dirks_IndividualSubsystem.kicad_sch]

Parts:
C1, C7: 10nF; C_01005_0402Metric
C2, C3: 2.2uF; C_0603_1608Metric
C4: .47uF; C_0201_0603Metric
C5, C10: 330pF; C_0201_0603Metric
C6: 10 uF; C_0805_2012Metric
C8: 22nF; C_0201_0603Metric
C9, C12, C14, C15: 22 uF; C_01005_0402Metric
C11: 100 nF; C_0201_0603Metric
C13: 150uF; C_1210_3225Metric
C16, C18, C21, C22, C30, C32: 100nF; C_0201_0603Metric
C17, C19, C20, C29, C31: 100uF; C_1210_3225Metric
C23, C24, C25, C26, C27, C28: 33nF; C_0805_2012Metric
D1, D2, D3, D4, D6: D; TO-252-3_TabPin2
D5: LED; LED_0805_2012Metric
F1: Fuse 4.5A; FUSE_4628
F2: Fuse 3.5 A; FUSE_4628
J1: Barrel_Jack; PJ-102AH_CUD
J2: CONN_USB3131-30-0230-A_GCT
J3: 8 Pin In; CONN_332LF_AMP
J4: 8Pin out; CONN_332LF_AMP
L1: 33uH; 33uFInductor
L2: 4.7 uH; 47uFInductor
M1, M2: Motor_Servo; 3PinScrewTerminal
M3, M4, M5: Motor_DC; 2PinScrewTerminal
R1: 49.9K; R_2512_6332Metric
R2: 20.5; R_2512_6332Metric
R3: 1.65K; R_1206_3216Metric
R4: 5.11K; R_2512_6332Metric
R5: 10; R_2512_6332Metric
R6, R7: 10K; R_2512_6332Metric
R9: 220; R_2512_6332Metric
R10, R11: 10k; R_2512_6332Metric
S1: fancyBTN_DPDT_TL2233_EWI
SW1, SW2: SW_DPST; standardPushButton
TP1, TP2, TP3, TP4, TP5, TP6, TP7, TP8, TP9, TP10, TP11, TP12, TP13, TP14, TP15, TP16, TP17, TP18, TP19, TP20, TP21, TP22, TP23, TP25, TP26, TP27, TP29, TP30, TP31, TP33, TP34, TP35: TestPoint_Small; PinHeader_1x01_P2.54mm_Vertical
U1, U2, U3: MotorDriver_IFX9201SGAUMA1
U4: n8ESP32-S3-WROOM-1_EXP
VR1: Buck2_5LM5005MHXNOPB
VR2: Buck2A_AP63203WU-7

Connections:
+3.3V: C15.1, C16.2, C31.1, C32.1, D2.2 (K), M2.2 (+), R6.1, R7.1, R11.2, TP29.1, U4.2 (3V3)
+5V: C17.1, C18.1, C19.1, C20.1, C21.1, C22.1, C29.1, C30.1, D3.2 (K), M1.2 (+), R10.2, TP17.1, U1.2 (VSO), U1.4 (VS), U2.2 (VSO), U2.4 (VS), U3.2 (VSO), U3.4 (VS)
+12V: D4.3 (A), F1.1, J1.1
GND: C2.2, C3.2, C4.1, C5.2, C6.2, C7.2, C9.2, C12.2, C13.2, C14.2, C15.2, C16.1, C17.2, C18.2, C19.2, C20.2, C21.2, C22.2, C23.1, C24.2, C25.1, C26.1, C27.2, C28.2, C29.2, C30.2, C31.2, C32.2, D5.1 (K), J1.2, J2.5 (GND), J2.S1 (Shield), J2.S2 (Shield), J3.8, J4.8, M1.3 (-), M2.3 (-), R2.2, R3.1, R5.1, S1.3, S1.6, SW1.2, SW1.4, SW2.2, SW2.4, TP4.1, TP5.1, TP6.1, TP7.1, TP8.1, TP9.1, TP10.1, TP11.1, TP12.1, TP15.1, TP16.1, TP35.1, U1.1 (DIR), U1.6 (GND), U1.11 (DIS), U1.12 (PWM), U1.13 (GND), U2.1 (DIR), U2.6 (GND), U2.11 (DIS), U2.12 (PWM), U2.13 (GND), U3.1 (DIR), U3.6 (GND), U3.11 (DIS), U3.12 (PWM), U3.13 (GND), U4.1 (GND), U4.40 (gnd), U4.41 (GND), U4.42 (GND), U4.43 (GND), U4.44 (GND), U4.45 (GND), U4.46 (GND), U4.47 (GND), U4.48 (GND), U4.49 (GND), VR1.10 (AGND), VR1.13 (PGND), VR1.14 (PGND), VR1.21 (GND_PAD), VR2.4 (GND)
MISO: TP13.1, U2.3 (SO), U4.19 (IO11)
MOSI: TP14.1, U1.8 (SI), U4.21 (IO13)
unnamed: C1.1, VR1.6 (COMP)
unnamed: C1.2, R1.1
unnamed: C4.2, VR1.1 (VCC)
unnamed: C5.1, VR1.9 (Ramp)
unnamed: C7.1, VR1.11 (SS)
unnamed: C8.1, VR1.20 (BST)
unnamed: C8.2, C10.1, D1.2 (K), L1.1, VR1.17 (SW1), VR1.19 (PRE)
unnamed: C10.2, R5.2
unnamed: C11.1, VR2.6 (BST)
unnamed: C11.2, L2.1, VR2.1 (FB), VR2.5 (SW)
unnamed: C9.1, C12.1, D2.1 (A), D2.3 (A), L2.2
unnamed: C13.1, C14.1, D3.3 (A), L1.2, R4.2, VR1.12 (Out)
unnamed: C23.2, M3.1 (+), U1.5 (OUT1)
unnamed: C24.1, M3.2 (-), U1.7 (Out2)
unnamed: C25.2, M4.1 (+), U2.5 (OUT1)
unnamed: C26.2, M5.1 (+), U3.5 (OUT1)
unnamed: C27.1, M4.2 (-), U2.7 (Out2)
unnamed: C28.1, M5.2 (-), U3.7 (Out2)
unnamed: D1.3 (A), VR1.15 (IS)
unnamed: D4.2 (K), F2.2
unnamed: D5.2 (A), R9.2
unnamed: J2.2 (D-), U4.13 (IO19)
unnamed: J2.3 (D+), U4.14 (IO20)
unnamed: J3.1, TP27.1
unnamed: J3.6, TP30.1
unnamed: J4.1, TP31.1
unnamed: J4.3, TP33.1
unnamed: R1.2, R3.2, R4.1, VR1.7 (FB)
unnamed: R2.1, VR1.8 (RT)
unnamed: R6.2, SW1.1, SW1.3, U4.3 (EN)
unnamed: R7.2, SW2.1, SW2.3, U4.27 (IO0)
unnamed: R9.1, TP25.1
unnamed: R10.1, S1.1
unnamed: R11.1, S1.4
unnamed: S1.2, TP26.1
unnamed: S1.5, TP34.1
unnamed: TP1.1, U2.8 (SI), U3.3 (SO)
unnamed: TP2.1, U4.11 (IO18)
unnamed: TP3.1, U4.12 (IO8)
unnamed: TP18.1, U4.35 (IO42)
unnamed: TP19.1, U4.34 (IO41)
unnamed: TP20.1, U4.32 (io39)
unnamed: TP21.1, U4.31 (IO38)
unnamed: TP22.1, U4.30 (IO37)
unnamed: TP23.1, U4.29 (IO26)
unnamed: U1.3 (SO), U3.8 (SI)
UartIn: D6.1 (A), J3.2, U4.36 (RXDX)
UartOut: D6.2 (K), J4.2, U4.37 (TXDX)
VDC: C2.1, C3.1, C6.1, F1.2, VR1.3 (VIN), VR2.2 (EN), VR2.3 (VIN)
chip select1: U1.9 (CSN), U4.22 (IO14)
chip select2: U3.9 (CSN), U4.23 (IO21)
chip select3: U2.9 (CSN), U4.24 (IO47)
clock line: U1.10 (SCK), U2.10 (SCK), U3.10 (SCK), U4.20 (IO12)
pwm1: M1.1 (PWM), U4.9 (IO16)
pwm2: M2.1 (PWM), U4.10 (IO17)
shareLine: F2.1, J3.7, J4.7

Notes on the sheet:
Debugging
Team Connectors
Power Regulation
2.5A
Necessary for Kicad to be happy regarding lines where 5v and 3.3v are either entering the system or exiting.
