JacobDirks/Dirks_EGR314_S26/(commit log)

2026-02-20 Update schematic assignment and add in RC servos
    [DirksPowerBudget.xlsx, Dirks_IndividualSubsystem.kicad_sch]
2026-02-20 Update site based on Ian's feedback
    [Dirks_IndividualSubsystem.kicad_sch]
2026-02-25 updating based on practical research
    [Dirks_IndividualSubsystem.kicad_sch]
2026-03-04 Update for Design Review
    [Dirks_IndividualSubsystem.kicad_sch]
2026-03-06 BOM and PCB file updates
    [DirksBOM.xlsx, Dirks_IndividualSubsystem.kicad_sch]
2026-03-07 Update BOM images and PCB page image review, and Index links
    [DirksBOM.xlsx]
2026-05-01 Update PCB information after building and add images
    [DirksBOM.xlsx]
2026-05-03 Add images to PCB
2026-05-03 Testing updated element for scroll bar and whatnot
    [DirksPowerBudget.xlsx, PowerBudgetExample.xlsx]
2026-05-03 Updating Mkdocs.yml to show final information
    [DirksPowerBudget.xlsx, PowerBudgetExample.xlsx]
